bergnoise/BABY/(list of files, drawings)

Other design files:
BABY_Kicad/freerouting.dsn
BABY_Kicad/temp-freerouting.dsn
