bergnoise/BABY/BABY_Kicad/BABY_Kicad.kicad_pcb

## KiCad design BABY_Kicad/BABY_Kicad.kicad_pcb (2023-07-04)

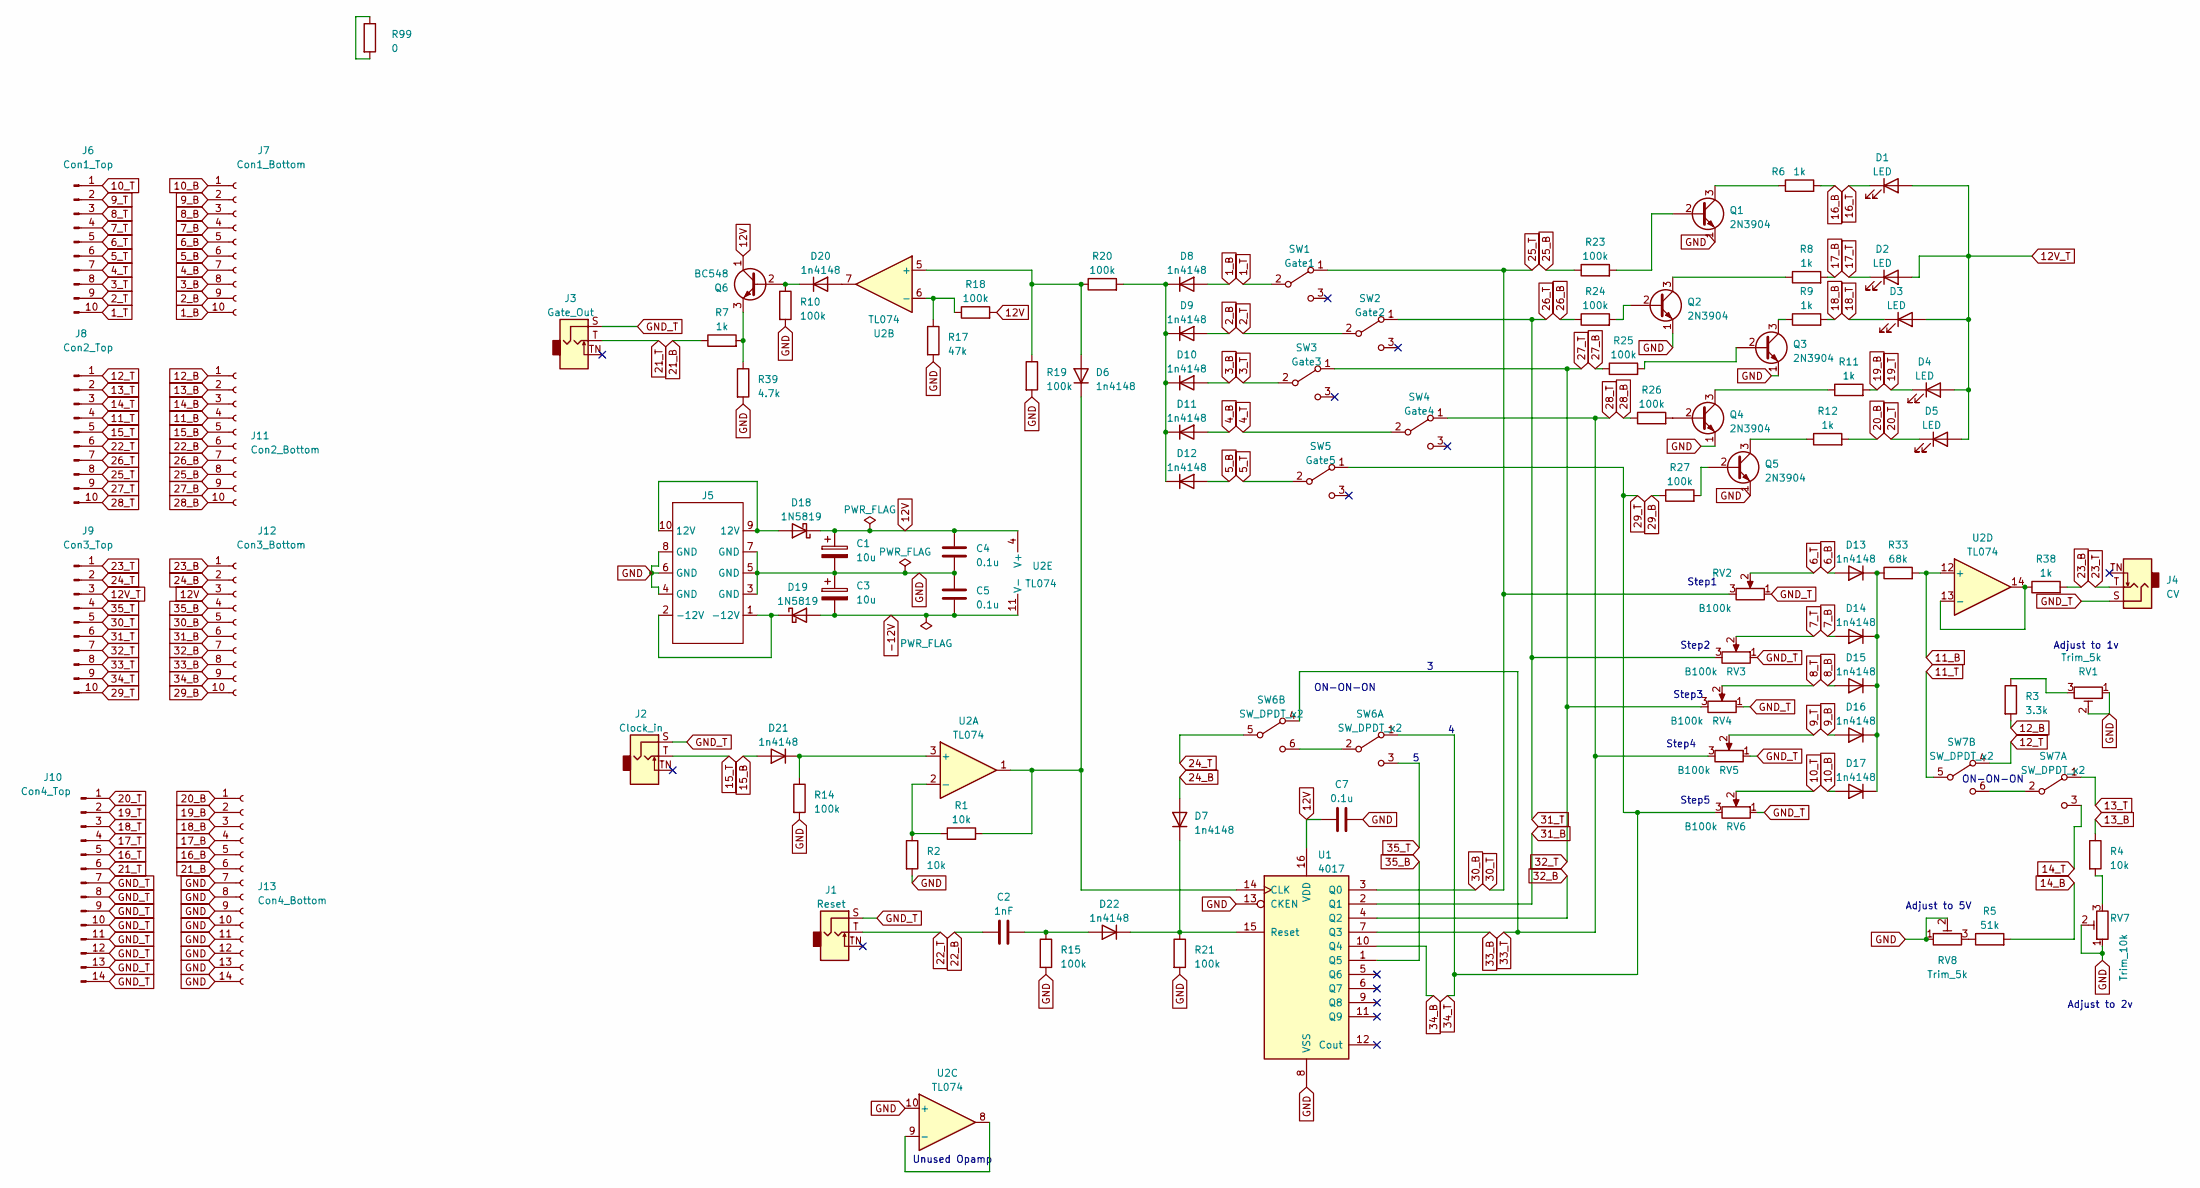
[picture p1: schematic BABY_Kicad.kicad_sch]

Parts:
C1, C3: 10u; Capacitor_Radial_D5.0mm_P2.5mm
C2: 1nF; Capacitor_Disc_D3.8mm_W2.6mm_P2.50mm
C4, C5, C7: 0.1u; Capacitor_Disc_D3.8mm_W2.6mm_P2.50mm
D1, D2, D3, D4, D5: LED; LED_D3.0mm
D6, D7, D8, D9, D10, D11, D12, D13, D14, D15, D16, D17, D20, D21, D22: 1n4148; D_DO-35_SOD27_P7.62mm_Horizontal
D18, D19: 1N5819; D_DO-41_SOD81_P10.16mm_Horizontal
J1: Reset; AudioJack_3.5mm
J2: Clock_in; AudioJack_3.5mm
J3: Gate_Out; AudioJack_3.5mm
J4: CV; AudioJack_3.5mm
J5: 10BoxHeaderConnector
J6: Con1_Top; PinHeader_1x10_P2.54mm_Vertical
J7: Con1_Bottom; PinHeader_1x10_P2.54mm_Vertical
J8: Con2_Top; PinHeader_1x10_P2.54mm_Vertical
J9: Con3_Top; PinHeader_1x10_P2.54mm_Vertical
J10: Con4_Top; PinHeader_1x14_P2.54mm_Vertical
J11: Con2_Bottom; PinHeader_1x10_P2.54mm_Vertical
J12: Con3_Bottom; PinHeader_1x10_P2.54mm_Vertical
J13: Con4_Bottom; PinHeader_1x14_P2.54mm_Vertical
Q1, Q2, Q3, Q4, Q5: 2N3904; TO-92_Wide
Q6: BC548; TO-92_Wide
R1, R2, R4: 10k; Resistor_L6.3mm_D2.5mm_P7.62mm_Horizontal
R3: 3.3k; Resistor_L6.3mm_D2.5mm_P7.62mm_Horizontal
R5: 51k; Resistor_L6.3mm_D2.5mm_P7.62mm_Horizontal
R6, R7, R8, R9, R11, R12, R38: 1k; Resistor_L6.3mm_D2.5mm_P7.62mm_Horizontal
R10, R14, R15, R18, R19, R20, R21, R23, R24, R25, R26, R27: 100k; Resistor_L6.3mm_D2.5mm_P7.62mm_Horizontal
R17: 47k; Resistor_L6.3mm_D2.5mm_P7.62mm_Horizontal
R33: 68k; Resistor_L6.3mm_D2.5mm_P7.62mm_Horizontal
R39: 4.7k; Resistor_L6.3mm_D2.5mm_P7.62mm_Horizontal
R99: 0; R_0201_0603Metric
RV1, RV8: Trim_5k; MultiturnTrimmer
RV2, RV3, RV4, RV5, RV6: B100k; Potentiometer_RV09
RV7: Trim_10k; MultiturnTrimmer
SW1: Gate1; SPDT_Tayda
SW2: Gate2; SPDT_Tayda
SW3: Gate3; SPDT_Tayda
SW4: Gate4; SPDT_Tayda
SW5: Gate5; SPDT_Tayda
SW6, SW7: SW_DPDT_x2; DPDT_Tayda
U1: 4017; DIP-16_W7.62mm_Socket_LongPads
U2: TL074; DIP-14_W7.62mm_Socket_LongPads

Connections:
1_B: D8.2 (A), J7.10
1_T: J6.10, SW1.2 (B)
2_B: D9.2 (A), J7.9
2_T: J6.9, SW2.2 (B)
3_B: D10.2 (A), J7.8
3_T: J6.8, SW3.2 (B)
4_B: D11.2 (A), J7.7
4_T: J6.7, SW4.2 (B)
5_B: D12.2 (A), J7.6
5_T: J6.6, SW5.2 (B)
6_B: D13.2 (A), J7.5
6_T: J6.5, RV2.2
7_B: D14.2 (A), J7.4
7_T: J6.4, RV3.2
8_B: D15.2 (A), J7.3
8_T: J6.3, RV4.2
9_B: D16.2 (A), J7.2
9_T: J6.2, RV5.2
10_B: D17.2 (A), J7.1
10_T: J6.1, RV6.2
11_B: J11.4, R33.2, U2.12 (+)
11_T: J8.4, SW7.5 (B)
12V: C1.1, C4.1, C7.1, D18.1 (K), J12.3, Q6.1 (C), R18.2, U1.16 (VDD), U2.4 (V+)
12V_T: D1.2 (A), D2.2 (A), D3.2 (A), D4.2 (A), D5.2 (A), J9.3
12_B: J11.1, R3.2
12_T: J8.1, SW7.4 (A)
13_B: J11.2, R4.1
13_T: J8.2, SW7.1 (A)
14_B: J11.3, R5.2
14_T: J8.3, SW7.3 (C)
15_B: D21.2 (A), J11.5
15_T: J2.T, J8.5
16_B: J13.5, R6.2
16_T: D1.1 (K), J10.5
17_B: J13.4, R8.2
17_T: D2.1 (K), J10.4
18_B: J13.3, R9.2
18_T: D3.1 (K), J10.3
19_B: J13.2, R11.2
19_T: D4.1 (K), J10.2
20_B: J13.1, R12.2
20_T: D5.1 (K), J10.1
21_B: J13.6, R7.1
21_T: J3.T, J10.6
22_B: C2.1, J11.6
22_T: J1.T, J8.6
23_B: J12.1, R38.2
23_T: J4.T, J9.1
24_B: D7.2 (A), J12.2
24_T: J9.2, SW6.5 (B)
25_B: J11.8, R23.1
25_T: J8.8, J9.5, RV2.3, SW1.1 (A)
26_B: J11.7, R24.1
26_T: J8.7, J9.6, RV3.3, SW2.1 (A)
27_B: J11.9, R25.1
27_T: J8.9, J9.7, RV4.3, SW3.1 (A)
28_B: J11.10, R26.1
28_T: J8.10, J9.8, RV5.3, SW4.1 (A), SW6.4 (A)
29_B: J12.10, R27.1
29_T: J9.9, J9.10, RV6.3, SW5.1 (A), SW6.1 (A)
30_B: J12.5, U1.3 (Q0)
31_B: J12.6, U1.2 (Q1)
32_B: J12.7, U1.4 (Q2)
33_B: J12.8, U1.7 (Q3)
34_B: J12.9, U1.10 (Q4)
35_B: J12.4, U1.1 (Q5)
35_T: J9.4, SW6.3 (C)
-12V: C3.2, C5.2, D19.2 (A), U2.11 (V-)
GND: C1.2, C3.1, C4.2, C5.1, C7.2, J5.3 (GND), J5.4 (GND), J5.5 (GND), J5.6 (GND), J5.7 (GND), J5.8 (GND), J13.7, J13.8, J13.9, J13.10, J13.11, J13.12, J13.13, J13.14, Q1.1 (E), Q2.1 (E), Q3.1 (E), Q4.1 (E), Q5.1 (E), R2.2, R10.2, R14.2, R15.2, R17.2, R19.2, R21.2, R39.2, RV1.1, RV1.2, RV7.1, RV7.2, RV8.1, RV8.2, U1.8 (VSS), U1.13 (CKEN), U2.10 (+)
GND_T: J1.S, J2.S, J3.S, J4.S, J10.7, J10.8, J10.9, J10.10, J10.11, J10.12, J10.13, J10.14, RV2.1, RV3.1, RV4.1, RV5.1, RV6.1
unnamed: D6.2 (A), R19.1, R20.1, U2.5 (+)
unnamed: D6.1 (K), R1.2, U1.14 (CLK), U2.1
unnamed: D8.1 (K), D9.1 (K), D10.1 (K), D11.1 (K), D12.1 (K), R20.2
unnamed: D13.1 (K), D14.1 (K), D15.1 (K), D16.1 (K), D17.1 (K), R33.1
unnamed: D18.2 (A), J5.9 (12V), J5.10 (12V)
unnamed: D19.1 (K), J5.1 (-12V), J5.2 (-12V)
unnamed: D20.2 (A), U2.7
unnamed: D20.1 (K), Q6.2 (B), R10.1
unnamed: D21.1 (K), R14.1, U2.3 (+)
unnamed: C2.2, D22.2 (A), R15.1
unnamed: D7.1 (K), D22.1 (K), R21.1, U1.15 (Reset)
unnamed: Q1.2 (B), R23.2
unnamed: Q1.3 (C), R6.1
unnamed: Q2.2 (B), R24.2
unnamed: Q2.3 (C), R8.1
unnamed: Q3.2 (B), R25.2
unnamed: Q3.3 (C), R9.1
unnamed: Q4.2 (B), R26.2
unnamed: Q4.3 (C), R11.1
unnamed: Q5.2 (B), R27.2
unnamed: Q5.3 (C), R12.1
unnamed: Q6.3 (E), R7.2, R39.1
unnamed: R3.1, RV1.3
unnamed: R4.2, RV7.3
unnamed: R5.1, RV8.3
unnamed: R99.1, R99.2
unnamed: SW6.2 (B), SW6.6 (C)
unnamed: SW7.2 (B), SW7.6 (C)
unnamed: R1.1, R2.1, U2.2 (-)
unnamed: R17.1, R18.1, U2.6 (-)
unnamed: U2.8, U2.9 (-)
unnamed: R38.1, U2.13 (-), U2.14

Notes on the sheet:
Unused Opamp
Adjust to 5V
Step5
ON-ON-ON
Adjust to 2v
Step2
Step1
Step3
Adjust to 1v
Step4

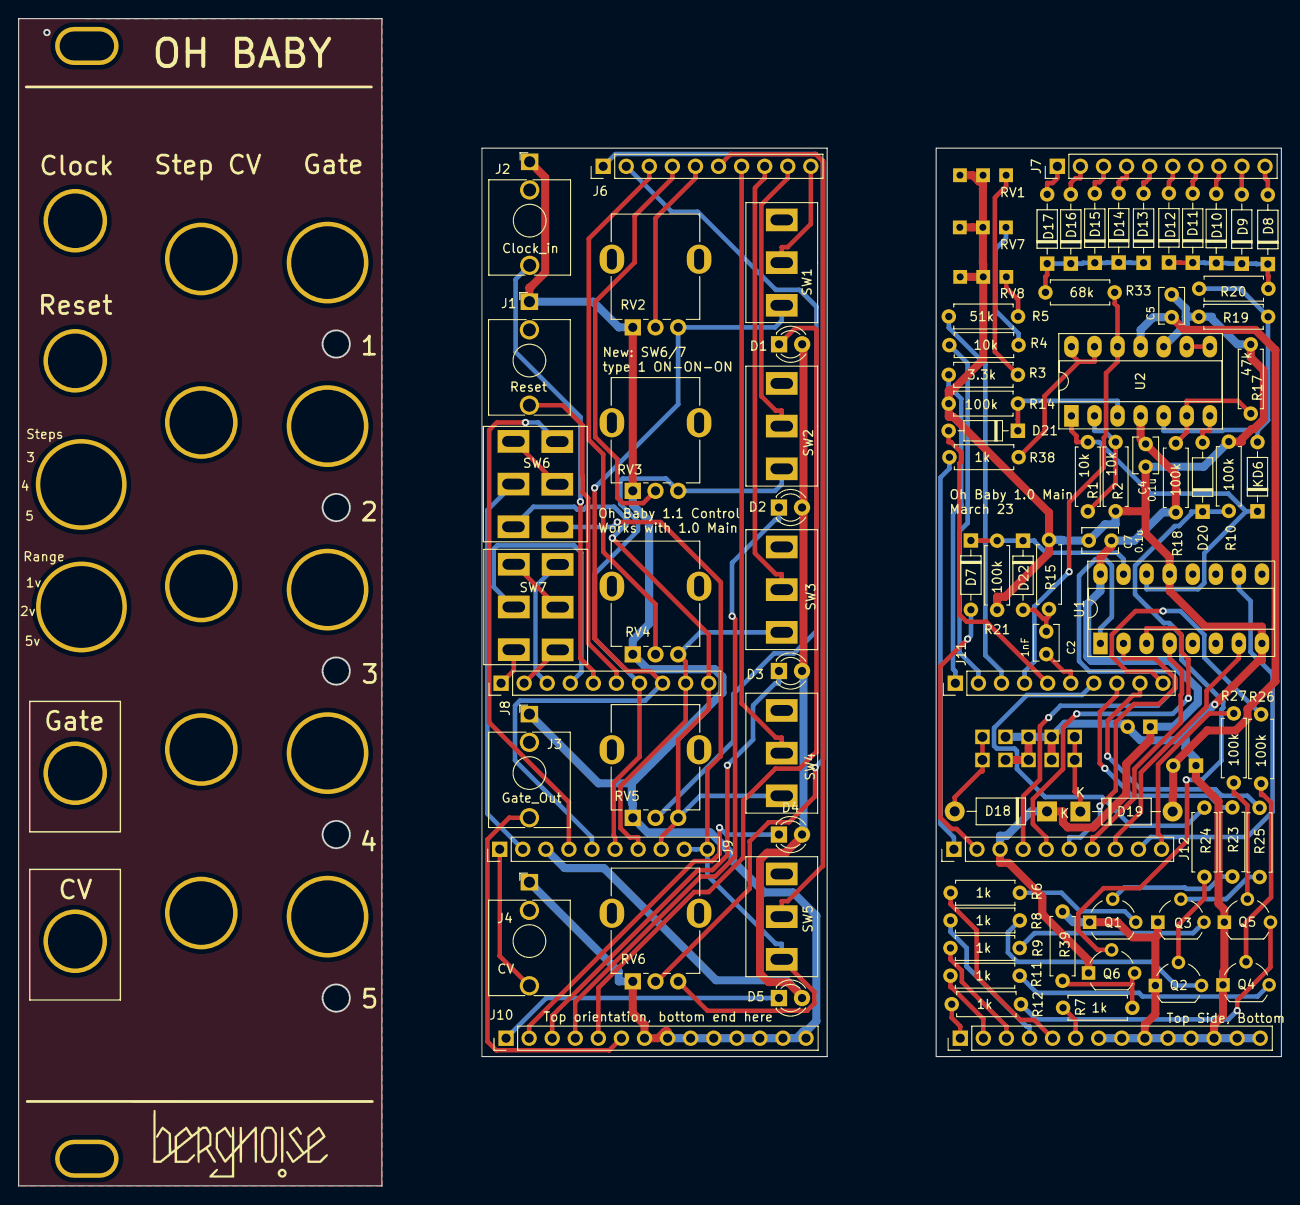
[picture p2: board BABY_Kicad.kicad_pcb from above]

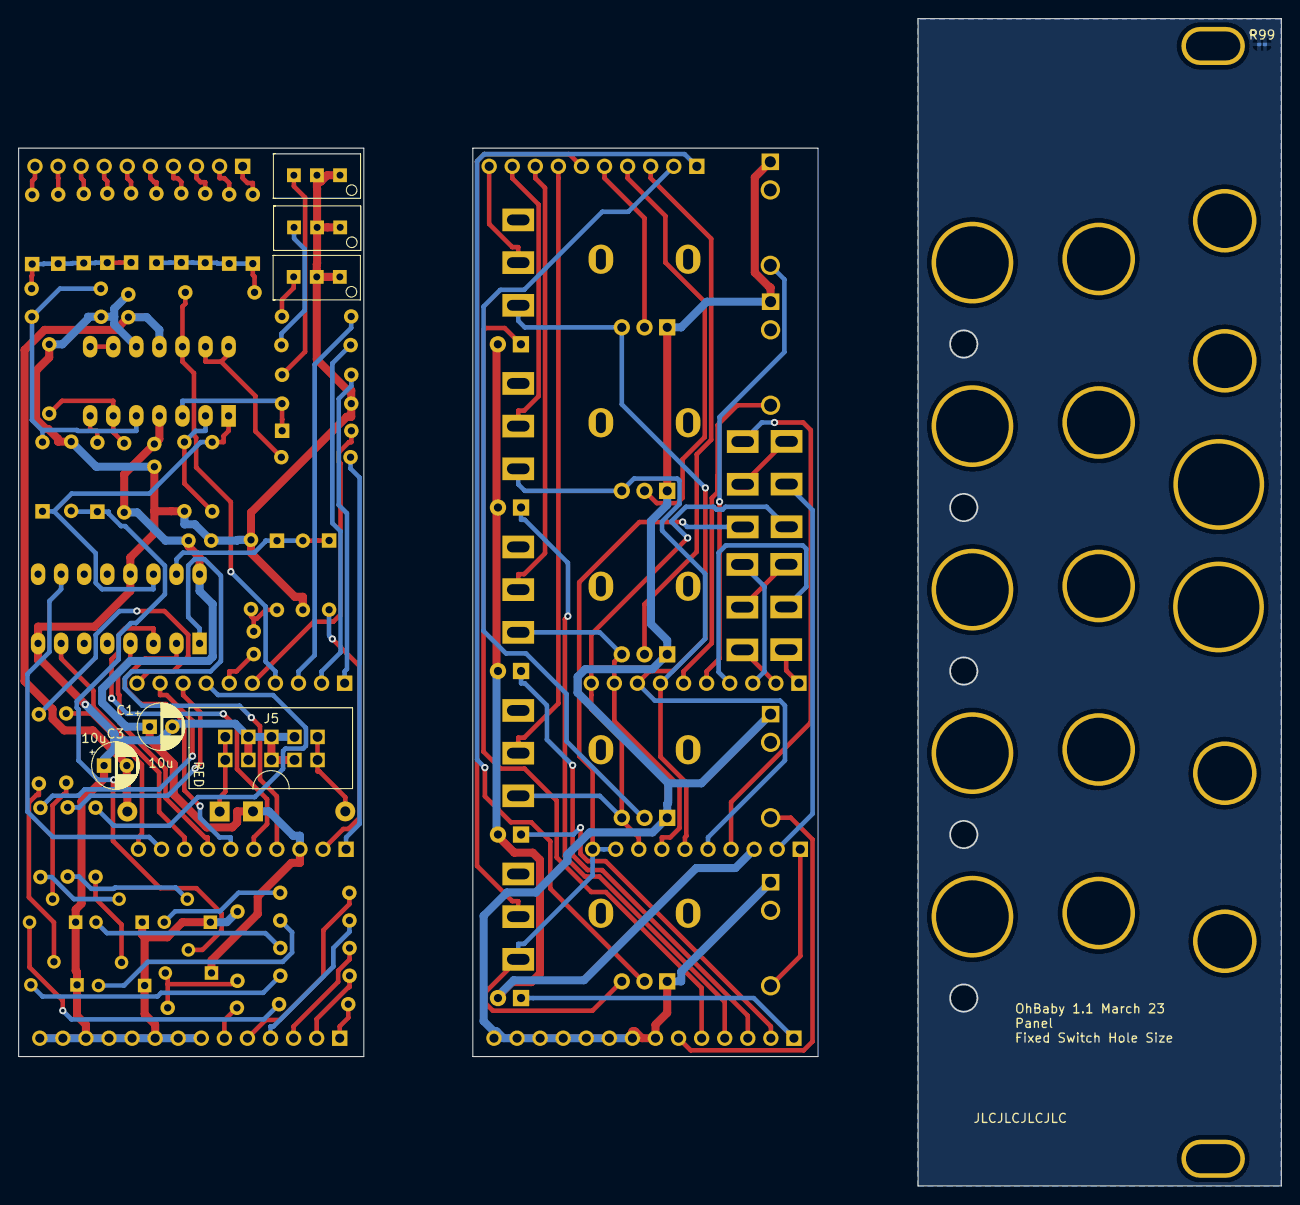
[picture p3: board BABY_Kicad.kicad_pcb from below]

Board: 2 copper layers, 139.0 x 128.5 mm, 110 parts (7 on the bottom side), 102 nets.

Other parts of the board:
REF1: Panel_8HP
REF2, REF5, REF12, REF15: PanelHole_AudioJack_3.5mm
REF3, REF7, REF11, REF14, REF17: PanelHole_ToggleSwitch_MTS-101
REF4, REF6, REF10, REF13, REF16: PanelHole_Potentiometer_RV09
REF8, REF9: PanelHole_DPDT_Tayda
Ref**: Val**; logo_v1
