bergnoise/BABY/(commit log)

2023-03-13 finished schematic
    [BABY_Kicad.kicad_pcb, BABY_Kicad.kicad_sch]
2023-03-14 started pcb
    [BABY_Kicad.kicad_pcb, BABY_Kicad.kicad_sch]
2023-03-15 finished pcb
    [BABY_Kicad.kicad_pcb, BABY_Kicad.kicad_sch, freerouting.dsn, temp-freerouting.dsn]
2023-03-26 first testrun
    [BABY_Kicad.csv, BABY_Kicad.kicad_pcb, BABY_Kicad.kicad_sch, bom.csv, control.kicad_pcb, designators.csv, main.kicad_pcb, panel.kicad_pcb]
